formulaslug/fs-3-intro-projects/README.md

# fs-3-intro-projects
Electrical design repository for intro projects pre FS-3
