formulaslug/fs-3-intro-projects/Arnesh Kumar/KiCad Workshop/report.txt

Info: Processing symbol 'BT1:FS_3_Global_Footprint_Library:MS621FE-FL11E_SEC'.
Info: Processing symbol 'D1:LED_SMD:LED_0805_2012Metric_Pad1.15x1.40mm_HandSolder'.
Info: Processing symbol 'R1:Resistor_SMD:R_0805_2012Metric_Pad1.20x1.40mm_HandSolder'.
Add BT1 (footprint 'FS_3_Global_Footprint_Library:MS621FE-FL11E_SEC').
Add D1 (footprint 'LED_SMD:LED_0805_2012Metric_Pad1.15x1.40mm_HandSolder').
Add R1 (footprint 'Resistor_SMD:R_0805_2012Metric_Pad1.20x1.40mm_HandSolder').

Info: Total warnings: 0, errors: 0.
