formulaslug/fs-3-intro-projects/Salil Khare/FirstKCAD Project/report.txt

Info: Processing symbol 'BT1:Battery:BatteryHolder_Seiko_MS621F'.
Info: Processing symbol 'D1:Diode_SMD:D_0805_2012Metric_Pad1.15x1.40mm_HandSolder'.
Info: Processing symbol 'R1:Resistor_SMD:R_0805_2012Metric_Pad1.20x1.40mm_HandSolder'.

Info: Total warnings: 0, errors: 0.
