formulaslug/fs-3-intro-projects/Pranav Kamat/LED_Project/LED_Project.kicad_pcb

## KiCad design Pranav Kamat/LED_Project/LED_Project.kicad_pcb (2025-01-29)

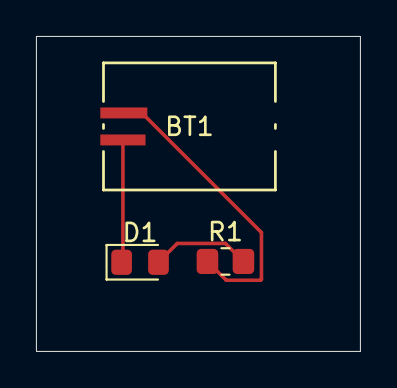
[picture p1: board LED_Project.kicad_pcb from above]

Board: 2 copper layers, 18.0 x 17.5 mm, 3 parts (0 on the bottom side), 3 nets.

Parts:
BT1: Battery_Cell; MS621FE-FL11E_SEC
D1: LED; D_0805_2012Metric_Pad1.15x1.40mm_HandSolder
R1: R; R_0805_2012Metric_Pad1.20x1.40mm_HandSolder

Connections:
unnamed: BT1.1 (+), R1.1
unnamed: BT1.2 (-), D1.1 (K)
unnamed: D1.2 (A), R1.2
