formulaslug/fs-3-intro-projects/DylanO/LED Demo/LED Demo.kicad_pcb

## KiCad design DylanO/LED Demo/LED Demo.kicad_pcb (2025-01-29)

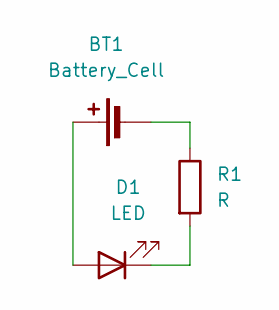
[picture p2: schematic LED Demo.kicad_sch, KiCad Workshop]

Parts:
BT1: Battery_Cell; MS621FE-FL11E_SEC
D1: LED; LED_0805_2012Metric_Pad1.15x1.40mm_HandSolder
R1: R; R_0805_2012Metric_Pad1.20x1.40mm_HandSolder

Connections:
unnamed: BT1.1 (+), D1.2 (A)
unnamed: BT1.2 (-), R1.1
unnamed: D1.1 (K), R1.2

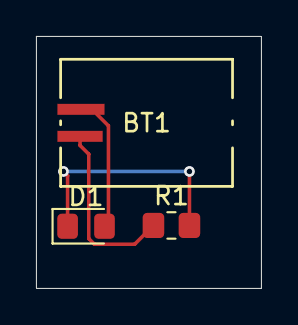
[picture p3: board DylanO/LED Demo/LED Demo.kicad_pcb from above]

Board: 2 copper layers, 12.5 x 14.0 mm, 3 parts (0 on the bottom side), 3 nets.
