formulaslug/fs-3-intro-projects/Francesco Menegoli/New kicad project/New kicad project.kicad_pcb

## KiCad design Francesco Menegoli/New kicad project/New kicad project.kicad_pcb (2025-01-29)

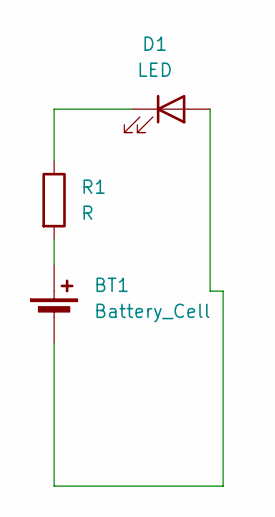
[picture p6: schematic New kicad project.kicad_sch]

Parts:
BT1: Battery_Cell; BatteryHolder_Seiko_MS621F
D1: LED; D_0805_2012Metric_Pad1.15x1.40mm_HandSolder
R1: R; R_0805_2012Metric_Pad1.20x1.40mm_HandSolder

Connections:
unnamed: BT1.1 (+), R1.2
unnamed: BT1.2 (-), D1.2 (A)
unnamed: D1.1 (K), R1.1

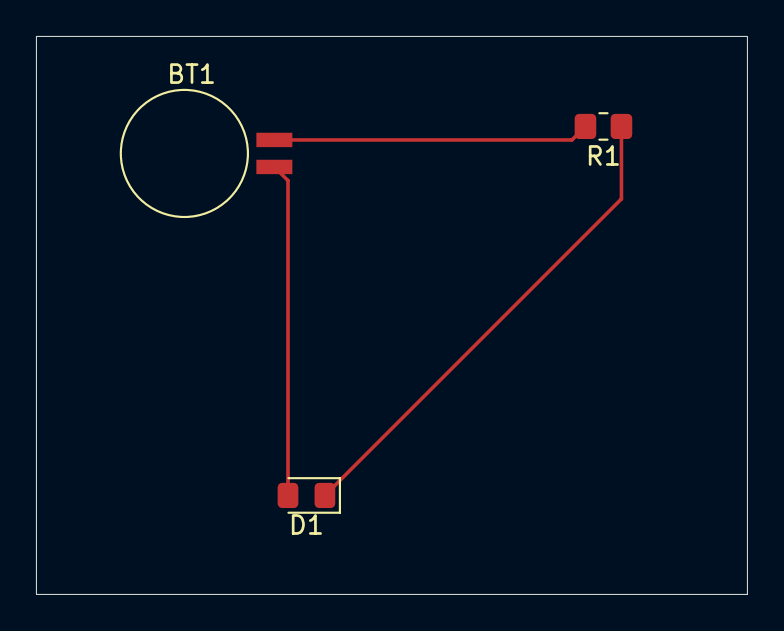
[picture p7: board New kicad project.kicad_pcb from above]

Board: 2 copper layers, 39.5 x 31.0 mm, 3 parts (0 on the bottom side), 3 nets.
