formulaslug/fs-3-intro-projects/Varish Venkatesh/New Project/Varish Venkatesh new project/Varish Venkatesh new project.kicad_pcb

## KiCad design Varish Venkatesh/New Project/Varish Venkatesh new project/Varish Venkatesh new project.kicad_pcb (2025-01-29)

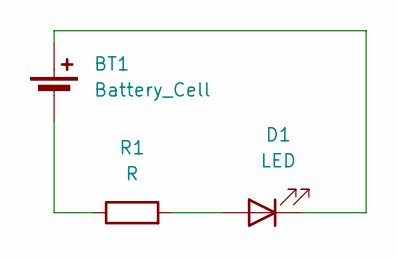
[picture p10: schematic Varish Venkatesh new project.kicad_sch]

Parts:
BT1: Battery_Cell; BatteryHolder_Seiko_MS621F
D1: LED; LED_0805_2012Metric_Pad1.15x1.40mm_HandSolder
R1: R; R_0805_2012Metric_Pad1.20x1.40mm_HandSolder

Connections:
unnamed: BT1.1 (+), D1.1 (K)
unnamed: BT1.2 (-), R1.1
unnamed: D1.2 (A), R1.2

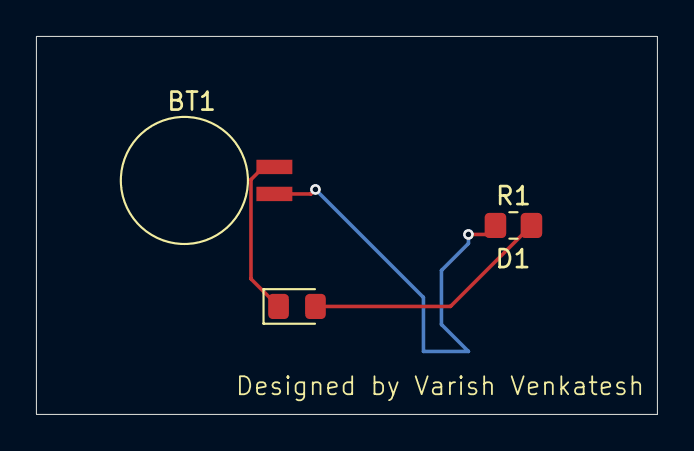
[picture p11: board Varish Venkatesh new project.kicad_pcb from above]

Board: 2 copper layers, 34.5 x 21.0 mm, 3 parts (0 on the bottom side), 3 nets.
