formulaslug/fs-3-intro-projects/anyewu/anyewu.kicad_sch

## KiCad design anyewu/anyewu.kicad_sch (2024-10-07)

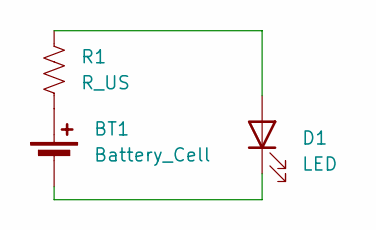
[picture p12: schematic anyewu.kicad_sch]

Parts:
BT1: Battery_Cell; MS621FE-FL11E_SEC
D1: LED; D_0805_2012Metric_Pad1.15x1.40mm_HandSolder
R1: R_US; R_0805_2012Metric_Pad1.20x1.40mm_HandSolder

Connections:
unnamed: BT1.1 (+), R1.2
unnamed: BT1.2 (-), D1.1 (K)
unnamed: D1.2 (A), R1.1
