formulaslug/fs-3-intro-projects/Aaron Ovadia/AO LED Demo/AO LED Demo.kicad_sch

## KiCad design Aaron Ovadia/AO LED Demo/AO LED Demo.kicad_sch (2024-10-08)

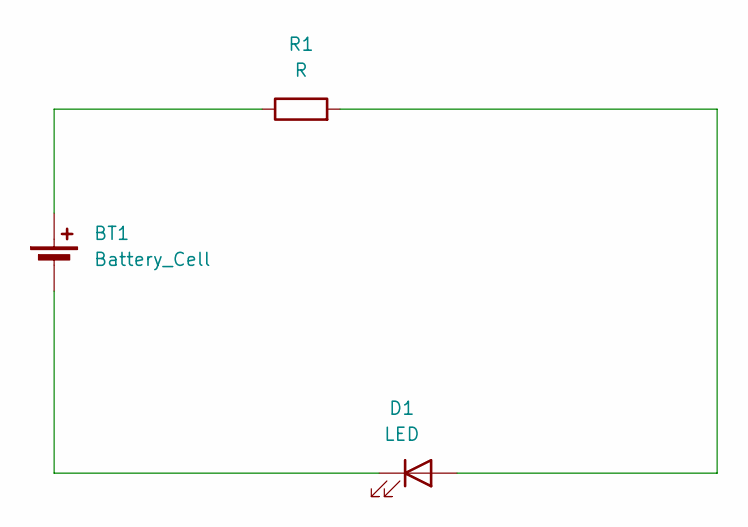
[picture p13: schematic AO LED Demo.kicad_sch]

Parts:
BT1: Battery_Cell; BatteryHolder_Seiko_MS621F
D1: LED; LED_0805_2012Metric_Pad1.15x1.40mm_HandSolder
R1: R; R_0805_2012Metric_Pad1.20x1.40mm_HandSolder

Connections:
unnamed: BT1.1 (+), R1.1
unnamed: BT1.2 (-), D1.1 (K)
unnamed: D1.2 (A), R1.2
