formulaslug/fs-3-intro-projects/Blu Hernandez/Project/Project.kicad_sch

## KiCad design Blu Hernandez/Project/Project.kicad_sch (2024-10-08)

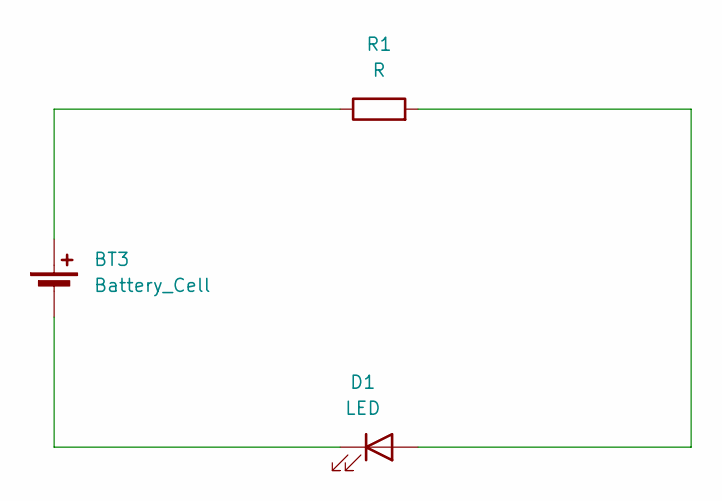
[picture p14: schematic Project.kicad_sch]

Parts:
BT3: Battery_Cell; BatteryHolder_Seiko_MS621F
D1: LED; LED_0805_2012Metric_Pad1.15x1.40mm_HandSolder
R1: R; R_0805_2012Metric_Pad1.20x1.40mm_HandSolder

Connections:
unnamed: BT3.1 (+), R1.1
unnamed: BT3.2 (-), D1.1 (K)
unnamed: D1.2 (A), R1.2
