formulaslug/fs-3-intro-projects/Ethan James/MyFirstKiCAD/MyFirstKiCAD.kicad_sch

## KiCad design Ethan James/MyFirstKiCAD/MyFirstKiCAD.kicad_sch (2024-10-07)

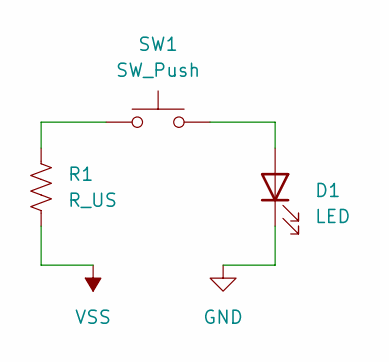
[picture p15: schematic MyFirstKiCAD.kicad_sch]

Parts:
D1: LED
R1: R_US
SW1: SW_Push

Connections:
GND: D1.1 (K)
unnamed: D1.2 (A), SW1.2
unnamed: R1.1, SW1.1
VSS: R1.2
