formulaslug/fs-3-intro-projects/Jack Nystrom/fs-intro/fs-intro.kicad_sch

## KiCad design Jack Nystrom/fs-intro/fs-intro.kicad_sch (2024-10-07)

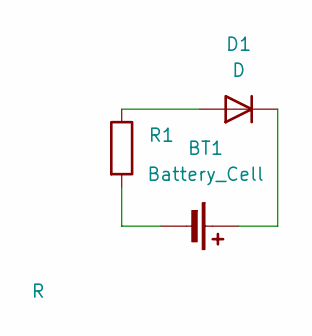
[picture p16: schematic fs-intro.kicad_sch]

Parts:
BT1: Battery_Cell; MS621FE-FL11E_SEC
D1: D; D_0805_2012Metric_Pad1.15x1.40mm_HandSolder
R1: R; R_0805_2012Metric_Pad1.20x1.40mm_HandSolder

Connections:
unnamed: BT1.1 (+), D1.1 (K)
unnamed: BT1.2 (-), R1.2
unnamed: D1.2 (A), R1.1
