formulaslug/fs-3-intro-projects/Jimmy Ho/introproject/introproject.kicad_sch

## KiCad design Jimmy Ho/introproject/introproject.kicad_sch (2024-10-07)

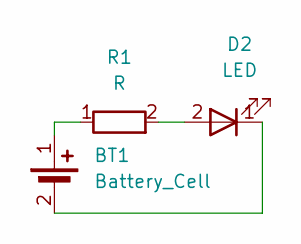
[picture p17: schematic introproject.kicad_sch]

Parts:
BT1: Battery_Cell; MS621FE-FL11E_SEC
D2: LED; LED_0805_2012Metric_Pad1.15x1.40mm_HandSolder
R1: R; R_0805_2012Metric_Pad1.20x1.40mm_HandSolder

Connections:
unnamed: BT1.1 (+), R1.1
unnamed: BT1.2 (-), D2.1 (K)
unnamed: D2.2 (A), R1.2
