formulaslug/fs-3-intro-projects/Jovanni Shen/IntroProject/IntroProject.kicad_sch

## KiCad design Jovanni Shen/IntroProject/IntroProject.kicad_sch (2024-10-07)

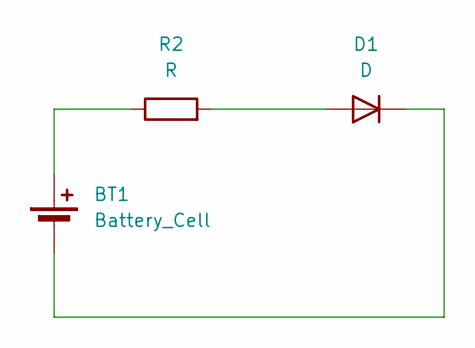
[picture p18: schematic IntroProject.kicad_sch]

Parts:
BT1: Battery_Cell; MS621FE-FL11E_SEC
D1: D; D_0805_2012Metric_Pad1.15x1.40mm_HandSolder
R2: R; R_0805_2012Metric_Pad1.20x1.40mm_HandSolder

Connections:
unnamed: BT1.1 (+), R2.1
unnamed: BT1.2 (-), D1.1 (K)
unnamed: D1.2 (A), R2.2
