formulaslug/fs-3-intro-projects/Layla Peachee/led_board/led_board.kicad_sch

## KiCad design Layla Peachee/led_board/led_board.kicad_sch (2024-10-09)

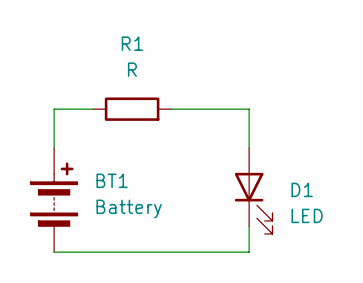
[picture p20: schematic led_board.kicad_sch]

Parts:
BT1: Battery; MS621FE-FL11E_SEC
D1: LED; LED_0805_2012Metric
R1: R; R_0805_2012Metric_Pad1.20x1.40mm_HandSolder

Connections:
unnamed: BT1.1 (+), R1.1
unnamed: BT1.2 (-), D1.1 (K)
unnamed: D1.2 (A), R1.2
