formulaslug/fs-3-intro-projects/Nicholas Tang/kicad challenge/kicad challenge.kicad_sch

## KiCad design Nicholas Tang/kicad challenge/kicad challenge.kicad_sch (2025-01-29)

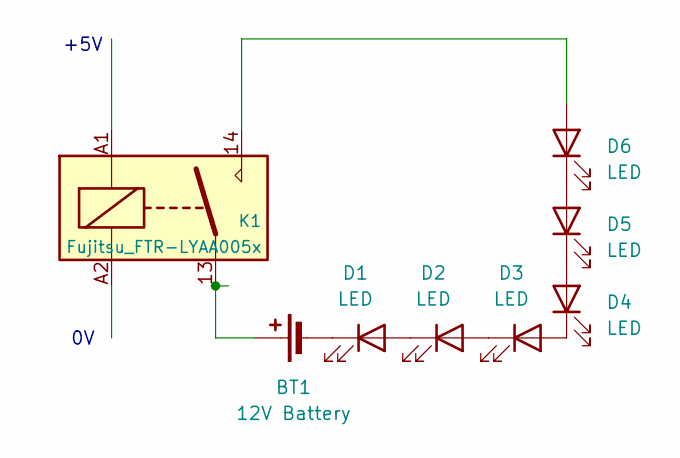
[picture p21: schematic kicad challenge.kicad_sch]

Parts:
BT1: 12V Battery
D1, D2, D3, D4, D5, D6: LED
K1: Fujitsu_FTR-LYAA005x; Relay_SPST-NO_Fujitsu_FTR-LYAA005x_FormA_Vertical

Connections:
unnamed: BT1.1 (+), K1.13
unnamed: BT1.2 (-), D1.1 (K)
unnamed: D1.2 (A), D2.1 (K)
unnamed: D2.2 (A), D3.1 (K)
unnamed: D3.2 (A), D4.1 (K)
unnamed: D4.2 (A), D5.1 (K)
unnamed: D5.2 (A), D6.1 (K)
unnamed: D6.2 (A), K1.14

Notes on the sheet:
+5V
