formulaslug/fs-3-intro-projects/(commit log)

2024-09-29 setting up first project demo
    [KiCad first project.kicad_pcb, KiCad first project.kicad_sch]
2024-10-07 created kicad project file
    [fs-intro.kicad_pcb, fs-intro.kicad_sch]
2024-10-07 idk first commit
    [KiCad first project.kicad_pcb, KiCad first project.kicad_sch]
2024-10-07 ok better commit with a project now
    [KiCad first project.kicad_sch, first project.kicad_pcb, first project.kicad_sch]
2024-10-07 Jack Nystrom: add first project
    [fs-intro.kicad_pcb, fs-intro.kicad_sch]
2024-10-07 Add intro project - Dustin Wang
    [IntroProject.kicad_pcb, IntroProject.kicad_sch]
2024-10-07 switched to my name folder
    [KiCad first project.kicad_pcb, KiCad first project.kicad_sch]
2024-10-07 Files Added
    [First Project.kicad_pcb, First Project.kicad_sch]
2024-10-07 KiCad Workshop
    [testOne.kicad_pcb, testOne.kicad_sch]
2024-10-07 pulling schematics commit
2024-10-07 IntroLED Board
    [Purav's Intro Project.kicad_pcb, Purav's Intro Project.kicad_sch]
2024-10-07 Finished First PCB
    [IntroProject.kicad_pcb, IntroProject.kicad_sch]
2024-10-07 commit 1
    [MyFirstKiCAD.kicad_pcb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]
2024-10-07 2nd commit
    [test.kicad_pcb]
2024-10-07 nathan pham my beloved
    [anyewu.kicad_pcb, anyewu.kicad_sch]
2024-10-07 commit of kicat circuit
2024-10-07 pcb
    made a basic pcb
    [introproject.kicad_pcb, introproject.kicad_sch]
2024-10-07 setup kicad
    [418121270808.stp, 434121025816.step, 632723130112.step, 632723300011.step, APHB1608.step, API_Series-500.kicad_pcb, API_Series-500.kicad_sch, Arduino_Mega.kicad_pcb]
2024-10-08 added new changes
    [Untitled.kicad_pcb, Untitled.kicad_sch]
2024-10-08 pcb demoing
    [KiCad first project.kicad_pcb, KiCad first project.kicad_sch, untitled.kicad_sch]
2024-10-08 add intro project
    [intro_project.kicad_pcb, intro_project.kicad_sch]
2024-10-08 KiCad Workshop Stuff
    [Adi-Intro-Project.kicad_pcb, Adi-Intro-Project.kicad_sch]
2024-10-08 PCB Workshop
    [LED Demo.kicad_pcb, LED Demo.kicad_sch]
2024-10-08 I finished my first PSB
    [AO LED Demo.kicad_pcb, AO LED Demo.kicad_sch]
2024-10-08 Simple LED Circuit
    [LED_Project.kicad_pcb, LED_Project.kicad_sch]
2024-10-08 first kicad workshop
    [First Project.kicad_pcb, First Project.kicad_sch]
2024-10-08 Create AO LED Demo-2024-10-08_110209.zip
2024-10-08 LED Demo
    [First Project.kicad_pcb, First Project.kicad_sch]
2024-10-08 first KiCad project
    [first project.kicad_pcb, first project.kicad_sch]
2024-10-08 Sai Pisupati - intro project
    [led_demo.kicad_pcb, led_demo.kicad_sch]
2024-10-08 Intro LED Demo
    Kicad Intro
    [LED Demo.kicad_pcb, LED Demo.kicad_sch]
2024-10-09 First Board
    [FirstBoard.kicad_pcb, FirstBoard.kicad_sch]
2024-10-09 Done with first PCB
    [LEDboard.kicad_pcb, LEDboard.kicad_sch]
2024-10-09 First PCB commit
    Description is the title
    [First_board.kicad_pcb, First_board.kicad_sch]
2024-10-09 intro project
    [led-board.kicad_pcb, led-board.kicad_sch]
2024-10-09 Intro KiCAD project
    [Intro KiCAD Project.kicad_pcb, Intro KiCAD Project.kicad_sch]
2024-10-09 version 1.0
    [Tharuka_LED_Board.kicad_pcb, Tharuka_LED_Board.kicad_sch]
2024-10-09 First ever pcb
    [First project.kicad_pcb, First project.kicad_sch]
2024-10-09 led board completed!
    [led_board.kicad_pcb, led_board.kicad_sch]
2024-10-09 LED board completed
    [LED_Board.kicad_pcb, LED_Board.kicad_sch]
2024-10-09 First PCB led board
    [First Project.kicad_pcb, First Project.kicad_sch]
2024-10-09 First PCB - LED
    First PCB!
    [LED_Project.kicad_pcb, LED_Project.kicad_sch]
2024-10-09 LED board completed
    completed LED board
    [LED_Board.kicad_pcb, LED_Board.kicad_sch]
2024-10-09 first pcb
    [New kicad project.kicad_pcb, New kicad project.kicad_sch]
2024-10-09 first pcb, testing github desktop
    [first_board.kicad_pcb, first_board.kicad_sch]
2024-10-09 Kicad Workshop Project
    First KiCad Project!!!
    [FirstKCAD Project.kicad_pcb, FirstKCAD Project.kicad_sch]
2024-10-09 Jaelyn Flores - First PCB
    [first LED project.kicad_pcb, first LED project.kicad_sch]
2024-10-09 First KiCad Project
    This is my first KiCad Project!!!
    [KiCad Workshop.kicad_pcb, KiCad Workshop.kicad_sch]
2024-10-09 Made a cool board!
    [eebeedoo.kicad_pcb, eebeedoo.kicad_sch]
2024-10-11 kicad challenge
    [kicad challenge.kicad_pcb, kicad challenge.kicad_sch]
2024-10-11 third demo
    [third demo.kicad_pcb, third demo.kicad_sch]
2024-10-11 Demo project!!
    [KiCad Project Intro 1.kicad_pcb, KiCad Project Intro 1.kicad_sch]
2024-10-11 deleted the laptop copy
    [418121270808.stp, 434121025816.step, 632723130112.step, 632723300011.step, APHB1608.step, API_Series-500.kicad_pcb, API_Series-500.kicad_sch, Arduino_Mega.kicad_pcb]
2024-10-12 Circuit board
    Made a circuit board with LED, resistor, and battery.
    [First Kicad Project - AY.kicad_pcb, First Kicad Project - AY.kicad_sch]
2024-10-14 Brake Light KiCad
    Brake Light KiCad
    [KiCad Brake Light Deisgn challenge.kicad_pcb, KiCad Brake Light Deisgn challenge.kicad_sch]
2024-10-14 Revert "Brake Light KiCad"
    This reverts commit fd12b972533ff68ad1195787e1e815de03854222.
    [KiCad Brake Light Deisgn challenge.kicad_pcb, KiCad Brake Light Deisgn challenge.kicad_sch]
2024-10-14 FS 3 Kicad challenge
    Brake Lights
    [KiCad Brake Light Deisgn challenge.kicad_pcb, KiCad Brake Light Deisgn challenge.kicad_sch]
2024-10-14 Edmund Lai KiCad Challenge
    Brake
2024-10-24 [Vir Shah] Pushing example project
    [LED Board.kicad_pcb, LED Board.kicad_sch]
2024-10-25 Made schematic and pcb
    added battery
    added led
    added resistor
    [Intro to kicad.kicad_pcb, Intro to kicad.kicad_sch]
2024-10-26 Intro Project Changes
    Peripheral Board
    [F3 peripheral boards.kicad_pcb, F3 peripheral boards.kicad_sch, LED Board.kicad_pcb, LED Board.kicad_sch]
2024-10-26 Peripheral boards
    [F3 peripheral boards.kicad_sch]
2024-10-28 Fourth demo
    [LED DEMO 4.kicad_pcb, LED DEMO 4.kicad_sch]
2024-10-28 Done with workshop!
    [LED Demo.kicad_pcb, LED Demo.kicad_sch]
2024-10-28 Done with KiCad workshop
    [LED Demo.kicad_pcb, LED Demo.kicad_sch]
2024-10-28 Finished KiCad workshop
    [LED Demo.kicad_pcb, LED Demo.kicad_sch]
2024-10-29 Finished PCB
    [led-maker.kicad_pcb, led-maker.kicad_sch]
2024-10-30 Finished first project
    [Intro Projects.kicad_pcb, Intro Projects.kicad_sch]
2024-10-30 Finished 1st board/pcb
    [LED Demo.kicad_pcb, LED Demo.kicad_sch]
2024-10-30 intro to kicad LED Demo
    [intro.kicad_pcb, intro.kicad_sch]
2024-10-30 Bryan Lu Work Done
    [They Finished.kicad_pcb, They Finished.kicad_sch]
2024-10-31 Peripheral Board Schematic
    [F3 peripheral boards.kicad_sch]
2024-10-31 Moved Peripheral Boards to fs-3 schematics
    [F3 peripheral boards.kicad_pcb, F3 peripheral boards.kicad_sch]
2024-10-31 Starting Intro Project(Christian)
    [IntroProjectFS.kicad_pcb, IntroProjectFS.kicad_sch]
2024-10-31 Finished Workshop
    [IntroProjectFS.kicad_pcb, IntroProjectFS.kicad_sch]
2024-10-31 Made intro pcb
    [firstProject.kicad_pcb, firstProject.kicad_sch]
2024-10-31 Update .DS_Store
    KiCad Workshop LED Demo
    1st: PCP
2024-10-31 KiCad Workshop LED Demo - Alejandro Munoz 10/31/24
    [KiCad Workshop Project AM.kicad_pcb, KiCad Workshop Project AM.kicad_sch]
2024-10-31 Kicad
    Made LED Circuit
    [New Project.kicad_pcb, New Project.kicad_sch, Varish Venkatesh new project.kicad_pcb, Varish Venkatesh new project.kicad_sch]
2024-12-04 MCU code v2
    Committing versions of CAN Bus read/write code -> code runs and executes, CAN cooperates to various degrees at various times
2025-01-08 1/7/25 CanBus Write Update
    Telemetry MCU team updated write code, implementing struct and cleaning up Kafka-esque code
2025-01-29 demo done
    [LED DEMO 6.kicad_pcb, LED DEMO 6.kicad_sch]
2025-01-29 LED done
    [LED Demo.kicad_pcb, LED Demo.kicad_sch]
2025-02-02 Create canBusDummy
    working CAN code!
2025-04-02 Write MVP and Working Write
    Updated versions, including the successful write at a minimum level and the current scaled version of write code
